Wolf1no/blender-macropad/BOM.csv

Part | Purpose | Qty | Unit price (USD) | Total (USD) | Vendor | Funding | Link
Pro Micro RP2040 | Main microcontroller | 1 | 4.39 | 4.39 | AliExpress | Hack Club | https://www.aliexpress.com/item/1005006967374887.html
Outemu Switches | Key switches | 1 | 5.69 | 5.69 | AliExpress | Hack Club | https://www.aliexpress.com/item/1005007345651159.html
Plum axis rotary encoder (EC11 20mm) | Zoom/scroll/volume control | 1 | 3.59 | 3.59 | AliExpress | Hack Club | https://www.aliexpress.com/item/1005008500548926.html
PCB (5 pcs) | Main board | 1 | 4.00 | 4.00 | JLCPCB | Hack Club | https://jlcpcb.com
Tax & shipping | Funded order (incl. EU import duty) |  |  | 15.04 |  | Hack Club
MOA Profile 1U PBT Blank Keycaps | Key caps | 1 | 4.94 | 4.94 | AliExpress | Self-funded | https://www.aliexpress.com/item/1005012146547025.html
Aluminum Alloy Potentiometer Knob | Knob for rotary encoder | 1 | 3.79 | 3.79 | AliExpress | Self-funded | https://www.aliexpress.com/item/1005005518894073.html
10k 0805 Resistor | Encoder pull-ups | 1 | 0.33 | 0.33 | AliExpress | Self-funded | https://www.aliexpress.com/item/1005007966254438.html
1N4148 DO-35 Diodes | Key matrix anti-ghosting | 1 | 1.94 | 1.94 | AliExpress | Self-funded | https://www.aliexpress.com/item/1005005435418695.html
2.08in OLED SH1122 | Display | 1 | 11.49 | 11.49 | AliExpress | Self-funded | https://www.aliexpress.com/item/1005009954575959.html
