Wolf1no/blender-macropad/BOM.md

# Blender Macropad – bill of materials

<!-- Generated by Half Life from project cmuwibvm408bj01osiigtos3r. Edits here are overwritten on the next sync. -->
<!-- Generated: 2026-10-12T02:57:52.851Z -->

> [!NOTE]
> This parts list is mirrored from [Half Life](https://halflife.hackclub.com). Editing it here will not change the platform's copy, and the next sync overwrites this file.

| Week | Tier | Parts funding |
| --- | --- | --- |
| Week 1 | Tier 1 | $30.00 |

| Part | What it's for | Qty | Unit | Total | Vendor |
| --- | --- | --- | --- | --- | --- |
| [Pro Micro RP2040](https://www.aliexpress.com/item/1005006967374887.html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) | Main microcontroller | 1 | $4.39 | $4.39 | [Aliexpress](https://www.aliexpress.com/item/1005006967374887.html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) |
| [Outemu Switches](https://www.aliexpress.com/item/1005007345651159.html) | Key switches | 1 | $5.69 | $5.69 | [Aliexpress](https://www.aliexpress.com/item/1005007345651159.html) |
| [Plum axis rotary encoder](https://www.aliexpress.com/item/1005008500548926.html) | Zoom/scroll/volume control | 1 | $3.59 | $3.59 | [Aliexpress](https://www.aliexpress.com/item/1005008500548926.html) |
| [PCB](https://cart.jlcpcb.com/) | Circuit board | 1 | $4.00 | $4.00 | [JLCPCB](https://cart.jlcpcb.com/) |
| **Parts subtotal** | — | — | — | **$17.67** | — |
| **Tax & shipping** | — | — | — | **$15.14** | — |
| **Total** | — | — | — | **$32.81** | — |

**$2.81 over the tier's funding.** Every tier gives a fixed amount for parts, so this needs cutting back or a higher tier.
