Wolf1no/blender-macropad/(list of files, drawings)

Other design files:
blender-macropad.dsn
temp-freerouting.dsn
