Wolf1no/blender-macropad/blender-macropad.kicad_pcb

## KiCad design blender-macropad.kicad_pcb (2026-10-12)

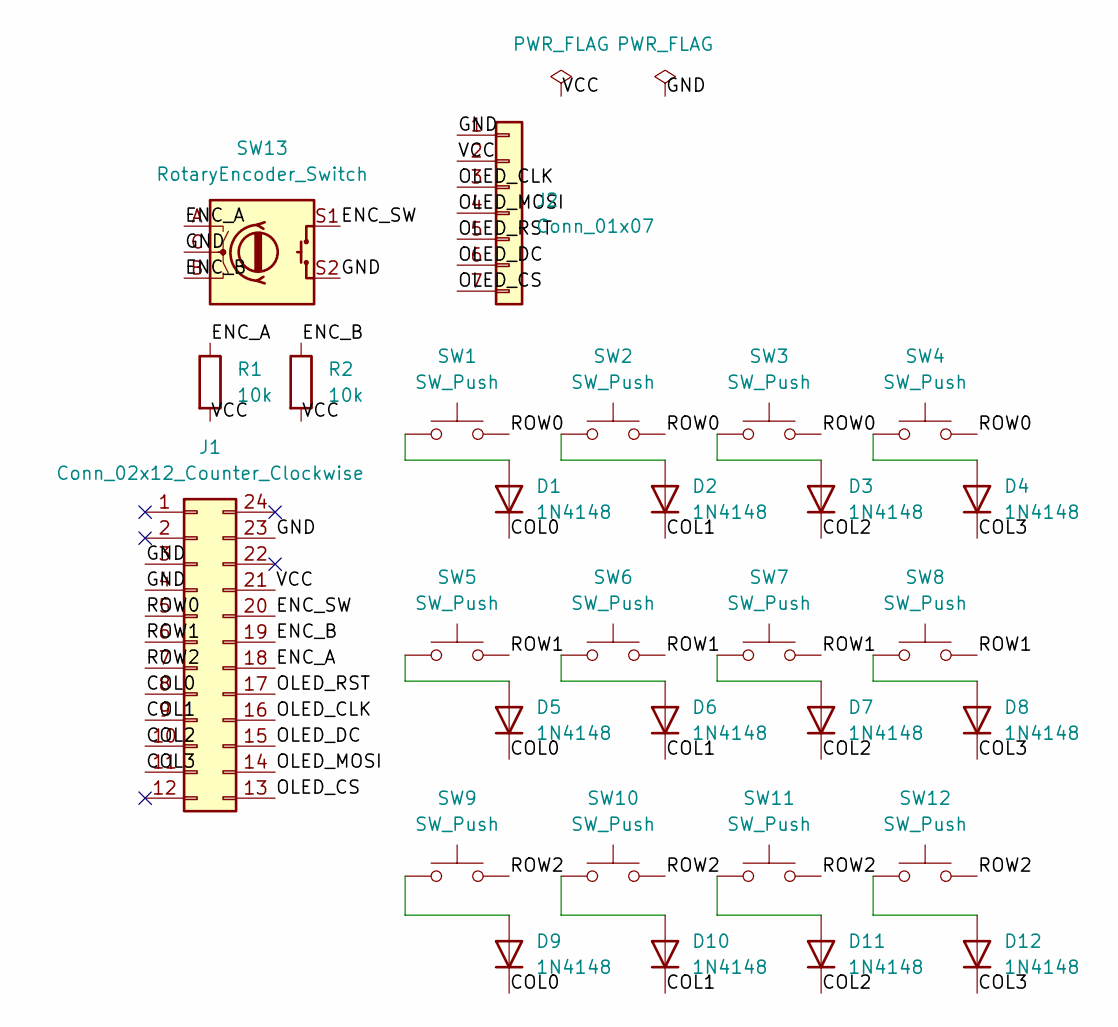
[picture p1: schematic blender-macropad.kicad_sch]

Parts:
D1, D2, D3, D4, D5, D6, D7, D8, D9, D10, D11, D12: 1N4148; D_DO-35_SOD27_P7.62mm_Horizontal
J1: Conn_02x12_Counter_Clockwise; DIP-24_W15.24mm
J2: Conn_01x07; PinHeader_1x07_P2.54mm_Vertical
R1, R2: 10k; R_0805_2012Metric
SW1, SW2, SW3, SW4, SW5, SW6, SW7, SW8, SW9, SW10, SW11, SW12: SW_Push; SW_Cherry_MX_1.00u_PCB
SW13: RotaryEncoder_Switch; RotaryEncoder_Alps_EC11E-Switch_Vertical_H20mm

Connections:
/COL0: D1.1 (K), D5.1 (K), D9.1 (K), J1.8
/COL1: D2.1 (K), D6.1 (K), D10.1 (K), J1.9
/COL2: D3.1 (K), D7.1 (K), D11.1 (K), J1.10
/COL3: D4.1 (K), D8.1 (K), D12.1 (K), J1.11
/ENC_A: J1.18, R1.1, SW13.A
/ENC_B: J1.19, R2.1, SW13.B
/ENC_SW: J1.20, SW13.S1
/GND: J1.3, J1.4, J1.23, J2.1, SW13.C, SW13.S2
/OLED_CLK: J1.16, J2.3
/OLED_CS: J1.13, J2.7
/OLED_DC: J1.15, J2.6
/OLED_MOSI: J1.14, J2.4
/OLED_RST: J1.17, J2.5
/ROW0: J1.5, SW1.2, SW2.2, SW3.2, SW4.2
/ROW1: J1.6, SW5.2, SW6.2, SW7.2, SW8.2
/ROW2: J1.7, SW9.2, SW10.2, SW11.2, SW12.2
/VCC: J1.21, J2.2, R1.2, R2.2
unnamed: D1.2 (A), SW1.1
unnamed: D2.2 (A), SW2.1
unnamed: D3.2 (A), SW3.1
unnamed: D4.2 (A), SW4.1
unnamed: D5.2 (A), SW5.1
unnamed: D6.2 (A), SW6.1
unnamed: D7.2 (A), SW7.1
unnamed: D8.2 (A), SW8.1
unnamed: D9.2 (A), SW9.1
unnamed: D10.2 (A), SW10.1
unnamed: D11.2 (A), SW11.1
unnamed: D12.2 (A), SW12.1

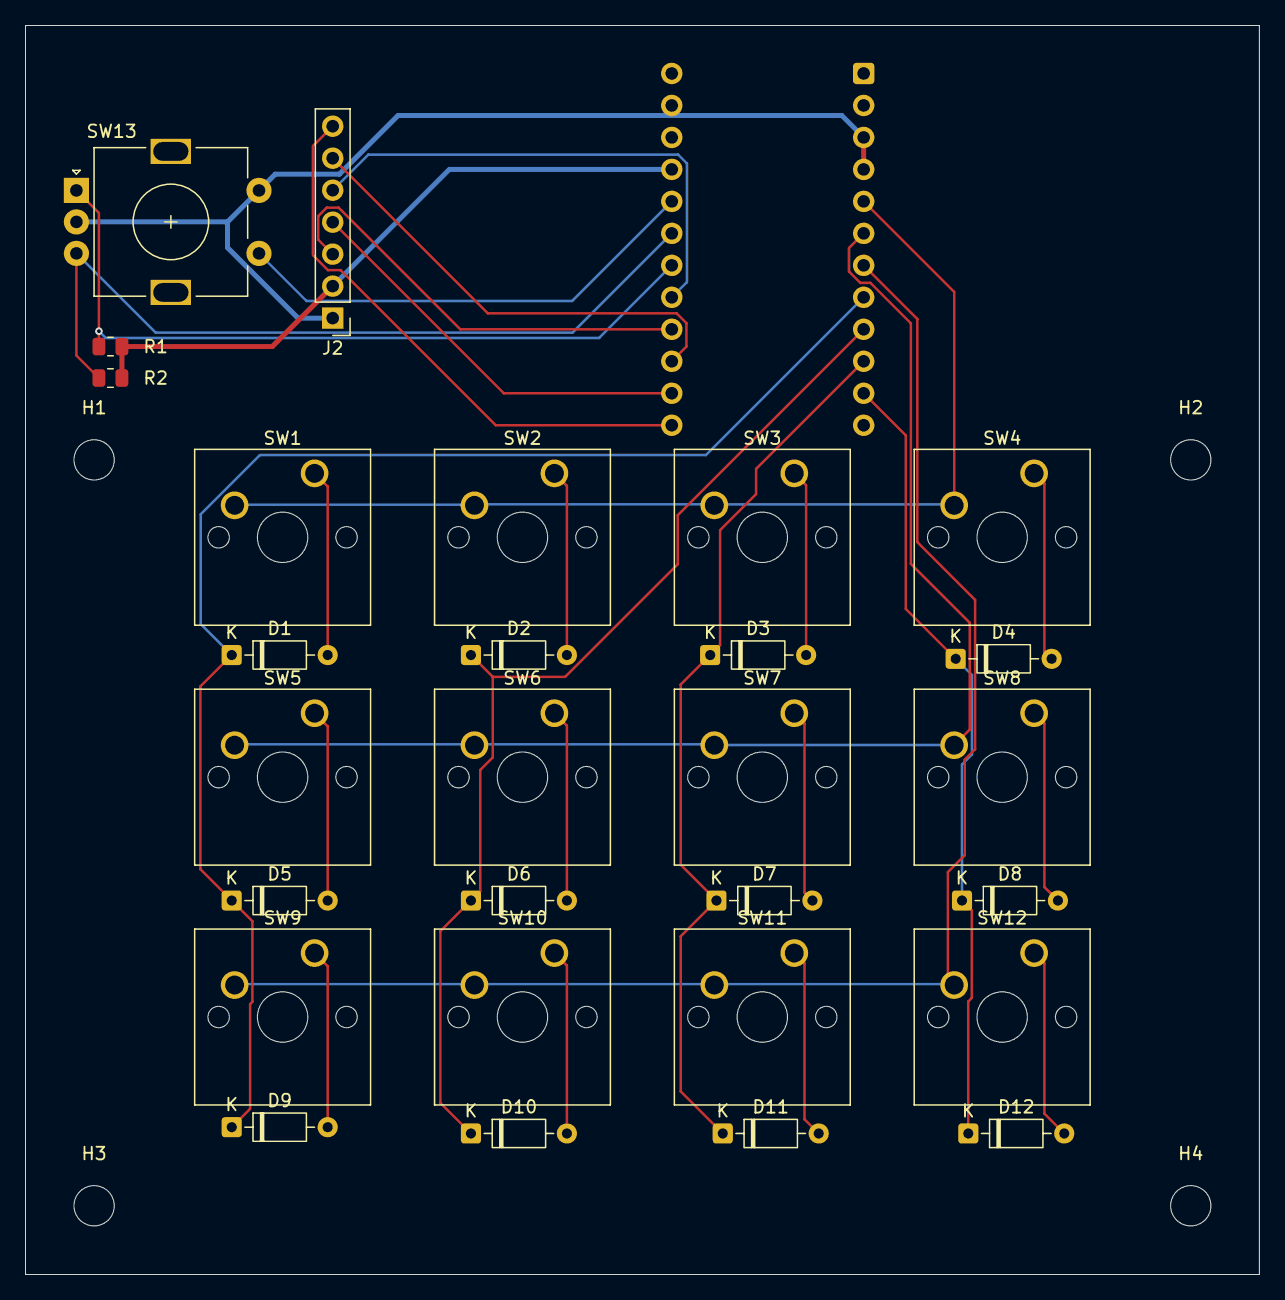
[picture p2: board blender-macropad.kicad_pcb from above]

Board: 2 copper layers, 98.0 x 99.2 mm, 33 parts (1 on the bottom side), 29 nets.

Other parts of the board:
H1, H2, H3, H4: M3; MountingHole_3.2mm_M3
