Wolf1no/blender-macropad/JOURNAL.md

# Blender Macropad – devlog

<!-- Generated by Half Life from project cmuwibvm408bj01osiigtos3r. Edits here are overwritten on the next sync. -->
<!-- Generated: 2026-10-12T02:42:58.059Z -->

> [!NOTE]
> This devlog is mirrored from [Half Life](https://halflife.hackclub.com). Editing it here will not change the platform's copy, and the next sync overwrites this file.

> A 12-key macropad with a rotary encoder, designed for Blender workflow.

| Week | Tier | Hours logged | Entries |
| --- | --- | --- | --- |
| Week 1 | Tier 1 | 13.5h | 7 |

## Contents

1. [2026-10-07 – # Started working on the macropad schematic.](#2026-10-07-started-working-on-the-macropad-schematic)
2. [2026-10-08 – ## Completing schematic](#2026-10-08-completing-schematic)
3. [2026-10-11 – # First try on PCB layout](#2026-10-11-first-try-on-pcb-layout)
4. [2026-10-11 – # PCB layout vol 2 xdd](#2026-10-11-pcb-layout-vol-2-xdd)
5. [2026-10-11 – # Routing finished, it's starting to look real!](#2026-10-11-routing-finished-its-starting-to-look-real)
6. [2026-10-11 – # Firmware and KMK setup](#2026-10-11-firmware-and-kmk-setup)
7. [2026-10-11 – # Insane PCB rework after friend's review](#2026-10-11-insane-pcb-rework-after-friends-review)

## Design

### 2026-10-07 – # Started working on the macropad schematic.

**3h**

# Started working on the macropad schematic.

So to begin with i have TKL keyboard, which means no numpad for me :D.  I'm trying to learn blender and get better in it so I need some sort of device to use as numpad.  Why? Well for viewport navigation! There are some workarounds but nothing is as good as numpad and why buy new keyboard or buy separated numpad when you can build something like macropad! So that's exactly what i will be trying to do for this weeks project.

My idea is 12 key (4x3) key macropad (custom bindings), with rotary encoder (zooming/volume adjustment) and OLED display (songs, stats/telemetry, etc.).

Started with installing KiCad and spent a while (honestly a lot longer then I expected) just clicking around and getting familiar with interface. There i found out that i should do some proper research first. So I dove right into it. First i had to figure out how keyboard matrices work, because it turns out you can't just wire each switch to it's own pin.  You would run out of GPIO pins very quickly. Instead you use matrix system (rows x columns). You wire it into matrix and scan them. But there is a catch! Without diodes, pressing multiple keys at once causes "ghosting"  that means that MCU thinks that you are pressing keys that you're not pressing. Which is ofc problem :D. So that's why i had to add 1N4148 diodes to prevent this issue.

This article helped me a lot: https://docs.qmk.fm/how_a_matrix_works

After this i started drawing the matrix in KiCad. Placed 12 Sw_Push symbols in 4x3 grid with 1N4148 diodes. Guess what. I messed up at first! xD I had all diodes upside down, but thanks to my friend (was showing him my progress and it caught his eye) I fixed the issue before advancing to wiring. Pretty lucky huh?

Screenshot 2026-10-07 at 10.09.09 PM
### *messed up so it's screenshot of screenshot, but here you can see part where I still had all my diodes flipped*

After that I started wiring it and i have made few mistakes here too. First mistake was pretty stupid honestly, I didn't realize that wires don't choose their path automatically. Sounds obvious, but my only experience with something similar to this was LOGO!soft comfort and in LOGO! wires can overlap etc.. Not in KiCad thought... But fortunately  I realized that and fixed it almost right away. (thank god i did, otherwise it would cause shortage. Second mistake came right after the first one, I've connected all of SWs and realized I can't connect diodes. Screenshot 2026-10-07 at 10.13.21 PM
### * messed up again, but here you can see I've fixed diodes and successfully messed up wiring xd*
So I did some research and found out about Labels,  Instead of physically wiring each pin you just create a label that counts as connection but leaves room for other cables while making the whole schematic A LOT cleaner.

Screenshot 2026-10-07 at 3.54.29 PM

### *Finished key matrix with labels (ROW0, COL0, etc.)*

**tl;dr:** Installed KiCad, 4x3 matrix with diodes finished + learned about KiCad, ghosting and why i need diodes.

**Next up:** MCU setup, encoder and OLED.

### 2026-10-08 – ## Completing schematic

**2h**

## Completing schematic

I was supposed to write this yesterday, because I will be describing my evening session, but since it was really late when i finished describing my first (afternoon) session, I had gone to sleep.

Let's start, for the MCU I went with Pro Micro RP2040 (18 GPIO pins, usb-c and runs CircuitPython/KMK) . First problem was, that KiCad doesn't have a Pro Micro in its symbol lib. At first i found something with same "id" but it was raw chip with over 50 pins. After doing some research I found out that such a chip needs external flash, voltage regulator and crystal, which is waaaay too complex . So I had to do proper research on how to solve this, one option was to download it from internet and add it, but than I stumbled across some reddit page where I learned that I can use generic 2x12 pin connector and label the pins manually to match the Pro Micro pinout.

Screenshot 2026-10-08 at 11.35.09 AM
### *2x12 pin connector with labeled pins*

Next thing was adding rotary encoder (EC11 with click --> adds more bindable options). Pins A and B for rotation, SW for the click + two 10k pullup resistors for A and B. Why pullups? Because without them the signal floats and rotation readings go crazy (floating is when pin is not connected to anything and it starts to pickup random noise, which makes readings go crazy)

Screenshot 2026-10-07 at 8.34.16 PM
### *Rotary Encoder*

For the OLED I  eventually chose a 2.08" SSD1322 over SPI. Why eventually? Honestly deciding which OLED to use was one of the hardest decisions so far, i wanted display that's big enough to cover the top right corner, while staying within budget and available pins. So calculation how big display I need and if I can afford it took pretty long time. So as I've already mentioned I decided to go with a 2.08" SSD1322, it's bigger then usual 0.96" OLEDs and needs 5 signal pins (MOSI, CLK, CS, DC, RST) instead of 2 for I2C. More wiring but better, since it's wider. Added it as 7 pin connector.

Ran ERC test at the end and finished with 4 errors for unused pins.

Screenshot 2026-10-07 at 8.36.34 PM
### *Finished ERC with 4 errors*

So I searched for a bit and found out that you have to mark unused pins. After I fixed it, it finished with 0 errors.

Screenshot 2026-10-07 at 8.36.08 PM
### *Finished schematic + ERC test with no errors*

**tl;dr:** Full schematic done, Pro Micro RP2040, encoder with pullups, SSD1322 OLED and clean ERC

**Next:**  PCB layout + board outline with component placement

### 2026-10-11 – # First try on PCB layout

**2h**

# First try on PCB layout

Hey guys so I finally got back to this project, if you wonder what took me so long I unfortunately got sick and could't work on this for almost 3 day. Which means it's right about time to finish this up. I started with PCB layout and very quickly realized how cooked I am. I was like "Maaan what the hell am  I looking at?".

Screenshot 2026-10-11 at 3.20.26 PM
### *Huge pile of components*

At first I didn't really want to do research on how to do this, so I played with it for a while, just to realize I can't do this on my own. (I heard, from my friend, that research time does not count)  But in the end it was good thing that I looked it up, because I found out I have wrong switch footprints, they were set to those small  usually black SMD buttons, which is not what I want. So i had to change all 12 of them to Cherry MX.

Then i drew a board outline, 60x70 (which later turned out to be huge mistake), no idea what was I thinking  honestly. Not knowing that my simple miss judgement would cause me so much trouble later i placed all components onto the board. (at this point I had no idea how grid snapping works, so it looked awful and was hell of a pain to get on the board) When I was finished I ran a DRC test and let's just say it didn't end well xdd.

Screenshot 2026-10-11 at 5.23.26 PM

### *Awful component placement + DRC with 54 error*

After this i realized 2 mistakes:
1. I forgot to re-Update PCB from schematics, which meant I still had wrong switches.
2. Obvious, DRC with 54 errors definitely means something is wrong.

This meant one and only one thing, I have to do it all over again... Because it's not ever worth fixing.

**tl;dr:** Messed up first PCB layout attempt, I will have to start over again

**Next:** Re-doing  this layout from scratch

### 2026-10-11 – # PCB layout vol 2 xdd

**1.5h**

# PCB layout vol 2 xdd

So as I said I deleted everything I've done so far (in layouting part ofc). This time I started with correct switches, and when I placed them onto my 60x70 board I found out that they would't fit. So I knew I can't just guess the size of the board. After doing a quick research I found out that MX switches have 19.05mm spacing. Quick math: I have 4 keys that's 19.05mm*4 and that would be 76.2mm + some margins so I went with 80mm, since I increased width by 20mm i decided to do the same with height. So i have 80x90mm board now.

Screenshot 2026-10-11 at 5.35.40 PM
### *Correct 80x90 board + correct switches, ready to start*

This time I placed componets using grid snapping. (correctly using). I made a custom "grid" with exactly 19.05mm, so all keys snapped exactly the same way and in correct distance from each other. I ran into not really a probleb, it would probably work either way, but i didn't feel good about it. I didn't know whee to pput the MCU connector, so I flipped onto back side of the board. After that i placed diodes, rezistors, OLED connecotr and encoder.

Screenshot 2026-10-11 at 8.27.51 PM
### *Finished PCB layout*

- Looks much beter now doesn't it : ).

**tl;dr:** Reworked PCB layout with correct dimensions and component spacings

**Next:** Routing and final DRC

### 2026-10-11 – # Routing finished, it's starting to look real!

**2h**

# Routing finished, it's starting to look real!

Now it's time to connect everything together. This was the most tedious part so far, I had to figure out which layer to route on (front, back side) and how to avoid crossing routes/traces.

The key matrix was the hardest part, there are so many things going on, that it was very hard not to mess up.Figuring out how to route diodes with switches without crossing other routes was mental.

Screenshot 2026-10-11 at 10.57.48 PM
### *Key matrix routed*

After routing key matrix I found out that I can't just connect everything on one side. So I ended up using vias (hole that connects front and back routes together) . After figuring that part out it was alot easier. Connecting encoder with resistors was super easy, since there is plenty of space up there. Same with OLED, except that one goes in to the middle, but as I said, after figuring out, that vias exist it was fine.

I also ran DRC test at the end, just to make sure there are no error. There were a few clearance issues, but i fixed those quickly by just moving routes around and final run was clean.

Screenshot 2026-10-11 at 11.29.05 PM
### *Finished routing and clean DRC*

I also checked 3D viewer and it looks good.

Screenshot 2026-10-11 at 11.30.31 PM

Screenshot 2026-10-11 at 11.30.17 PM

### *3D renders of routed PCB*

**tl;tr:**  Routing done, DRC clean and board looks good in 3D

**Next:** firmware and KMK setup

### 2026-10-11 – # Firmware and KMK setup

**1h**

# Firmware and KMK setup

So i need that research is not really counted as project time, but in this case there is not really an option, so I decided to count at least the debugging part, where I had to deal with things not working. The initial research and understanding of KMK took 2.5 hours and is not counted.

As I already mentioned i went with KMK, most of macropads are using it and there is no better option.

When i started writing the code I started with obvious and thats importing libraries, after that I Set up the matrix pins to match my scheme (3 row pins and 4 column pins) and diode orientation. Then added the encoder hendler with rotation map to volume control for now and click to mute. Might change it, or add when pressed rotation bindings later.

Screenshot 2026-10-11 at 11.53.26 PM
### *First steps*

For key map i went with numpad layout, since that's kinda why I'm doing this exact project. These bindings can be changed easily at any time, So if someone wanted to use this project they wouldn't have to worry about having useless bindings. Might add documentation on how to do so later.

Screenshot 2026-10-12 at 12.34.35 AM
### *Finished code*

**tl;dr** Firmware written , used KMK. Basic keybinds mapped, might change them after i test it out irl

**Next** BOM with actual prices and README

### 2026-10-11 – # Insane PCB rework after friend's review

**2h**

# Insane PCB rework after friend's review

So i thought I was finally finished, pushing last updates etc. And than i thought I could ask my friend to review my PCB, so he did and he's found few major mistakes.

Main issues he found:
- wrong OLED pin order, would have swapped power pins and killed the display
- MCU pins fro the OLED were mapped wrong
- Board was too small, OLED wouldn't fit (can't believe i didn't realize before he mentioned it)
- Pro Micro was completely wrong, the one I had there had wrong footprint with different spacing.

With his helped I reworked everything. Board went from 80x90 to 98x99.2. Remapped all the pins, fixed OLED connectors, also added M3 bolt holes on his suggestio, after all that we rerouted everything. Also we alligned usbC port with the edge of PCB so it's easily accessible and added display dimension, so it's easier to see where will it be.

He also recommended adding silkscreen labels so I don't solder it the wrong way.

Screenshot 2026-10-12 at 2.42.17 AM
### *Fixed PCB*

The firmware needed changes too. Since the PCB was rewired, I updated all the pins in code.py to match the new layout (rows GP2-GP4, columns GP5-GP8, encoder GP27-GP29) and switched the diode orientation to ROW2COL. I also changed the pins to use microcontroller.pin instead of board, because my Pro Micro clone doesn’t have an official CircuitPython build, so some board pin names might not exist.

The bigger problem is the display. KMK and CircuitPython don’t have a driver for its SH1122 controller, so I’ll have to write my own. For now I don’t have the capacity to do that so I disabled the whole display section and left a TODO comment. I’ll get back to it once the display arrives and I can test it properly.

Screenshot 2026-10-12 at 4.42.08 AM
### *Updated code*
