Wolf1no/blender-macropad/(commit log)

2026-10-07 initial schematic
    complete PCB schematic from KiCad: key matrix, MCU, rotary encoder, OLED
    [blender-macropad.kicad_pcb, blender-macropad.kicad_sch]
2026-10-11 initial pcb layout attempt
2026-10-11 reworked pcb layout
    polished pc layout with correct dimension
2026-10-12 Updated PCB
    Fixed PCB
2026-10-12 Adding BOM.csv
